semmelrinde/e2-lite-tag-connect-tc2030-adapter/images/schematic.pdf

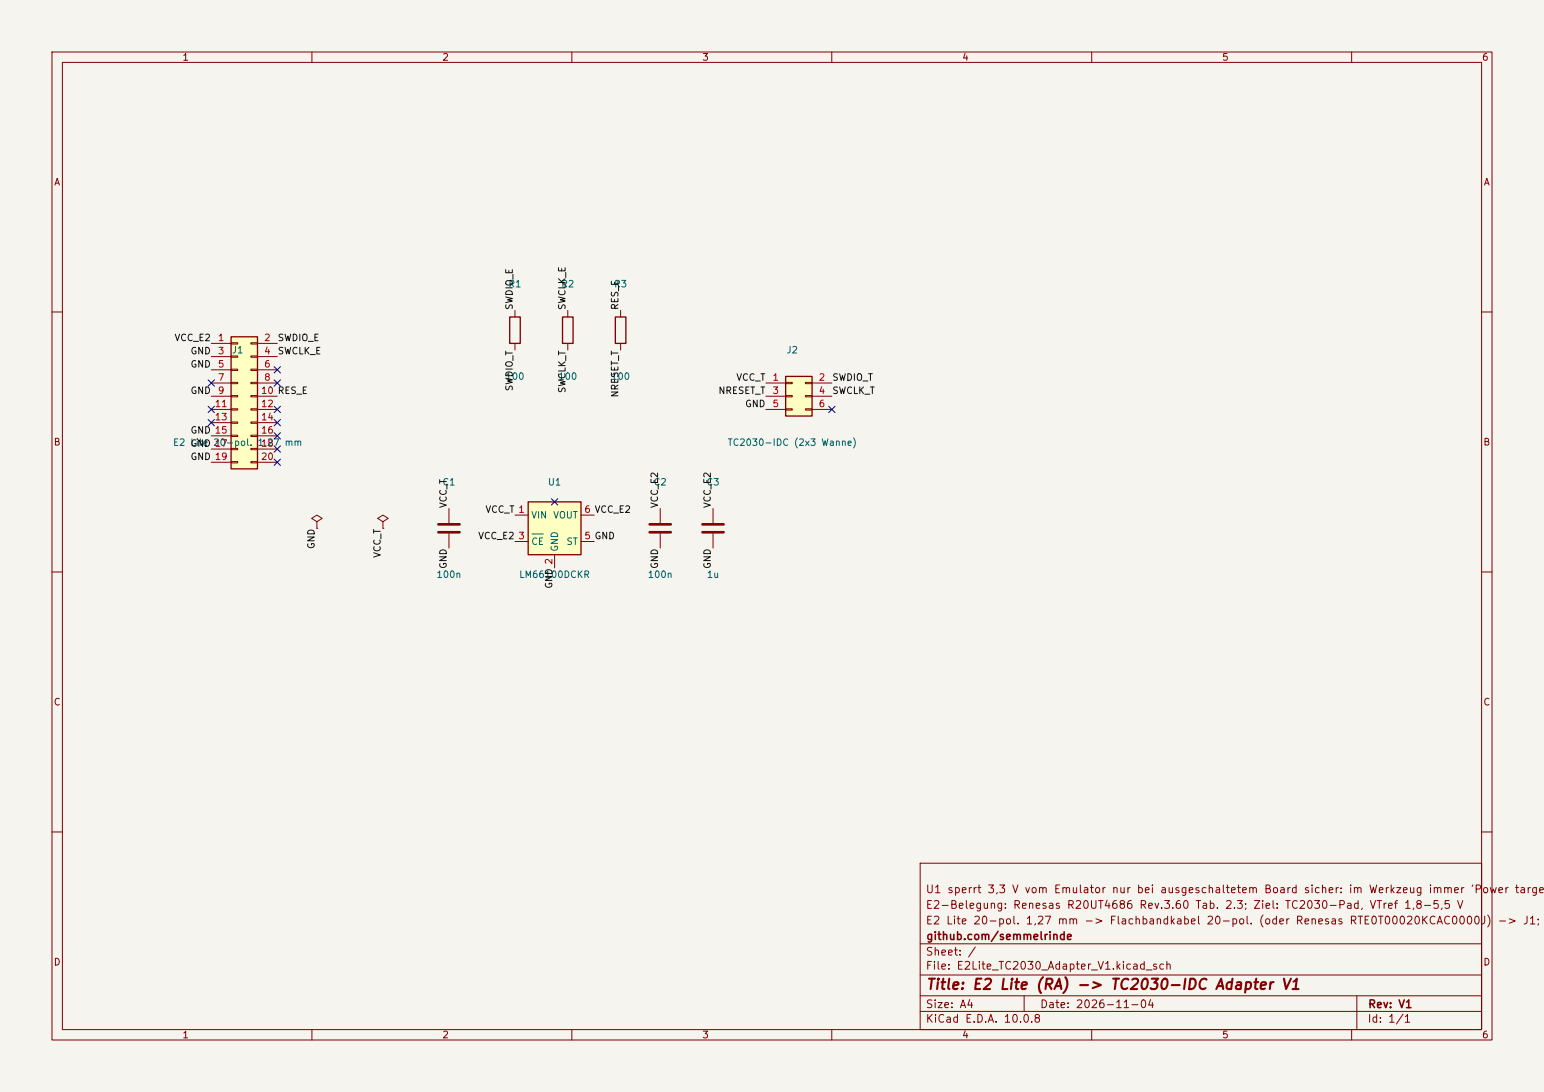
[picture p4: page 1]

U1 sperrt 3,3 V vom Emulator nur bei ausgeschaltetem Board sicher: im Werkzeug immer 'Power target: No'
E2-Belegung: Renesas R20UT4686 Rev.3.60 Tab. 2.3; Ziel: TC2030-Pad, VTref 1,8-5,5 V
E2 Lite 20-pol. 1,27 mm -> Flachbandkabel 20-pol. (oder Renesas RTE0T00020KCAC0000J) -> J1; TC2030-IDC -> J2
github.com/semmelrinde
Sheet: /
File: E2Lite_TC2030_Adapter_V1.kicad_sch
Title: E2 Lite (RA) -> TC2030-IDC Adapter V1

Size: A4 | Rev: V1
KiCad E.D.A. 10.0.8 | Id: 1/1
