semmelrinde/e2-lite-tag-connect-tc2030-adapter/hardware/E2Lite_TC2030_Adapter_V1.kicad_pcb

## KiCad design hardware/E2Lite_TC2030_Adapter_V1.kicad_pcb (2026-11-04)

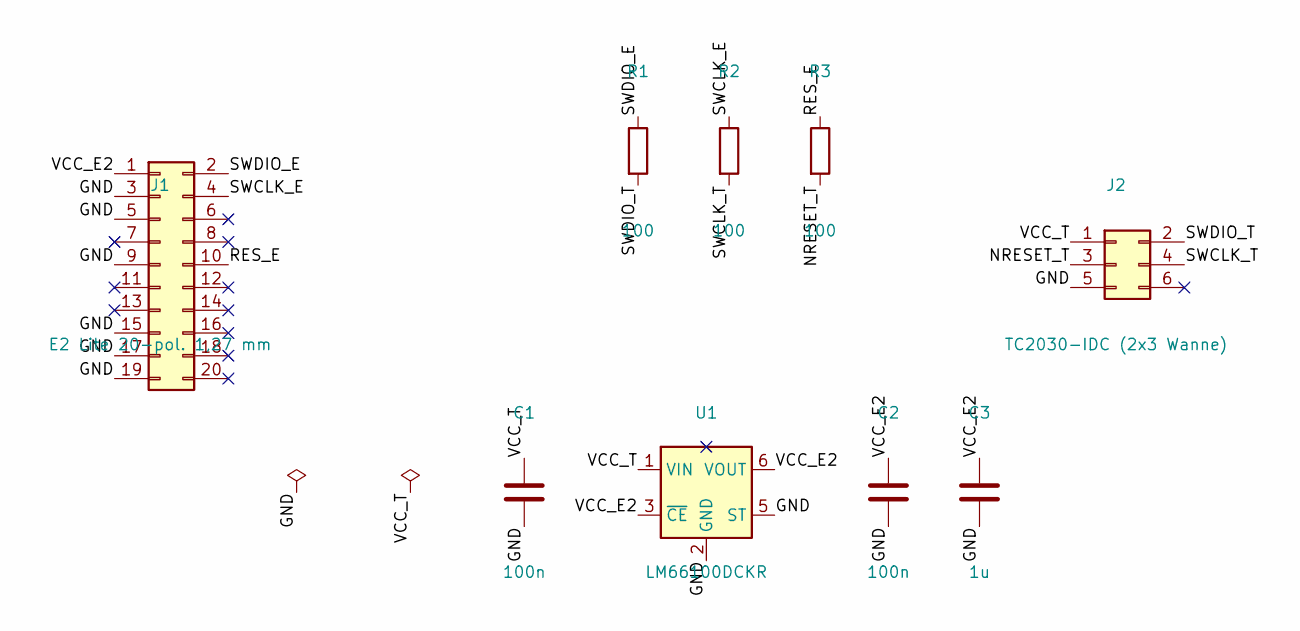
[picture p5: schematic E2Lite_TC2030_Adapter_V1.kicad_sch, E2 Lite (RA) -> TC2030-IDC Adapter V1]

Parts:
C1, C2: 100n; C_0603_1608Metric_Pad1.08x0.95mm_HandSolder; MPN 100 nF 0603
C3: 1u; C_0603_1608Metric_Pad1.08x0.95mm_HandSolder; MPN 1 uF 0603
J1: E2 Lite 20-pol. 1,27 mm; BoxHeader_2x10_P1.27mm_Vertical_DC3; MPN DC3 Wannenstecker 2x10 1,27 mm gerade T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
J2: TC2030-IDC (2x3 Wanne); IDC-Header_2x03_P2.54mm_Vertical; MPN Wannenstecker 2x3 2,54 mm gerade THT
R1, R2, R3: 100; R_0603_1608Metric_Pad0.98x0.95mm_HandSolder; MPN 100 Ohm 0603
U1: LM66100DCKR; SOT-363_SC-70-6_HandSolder; MPN LM66100DCKR

Connections:
/GND: C1.2, C2.2, C3.2, J1.3, J1.5, J1.9, J1.15, J1.17, J1.19, J2.5, U1.2 (GND), U1.5 (ST)
/NRESET_T: J2.3, R3.2
/RES_E: J1.10, R3.1
/SWCLK_E: J1.4, R2.1
/SWCLK_T: J2.4, R2.2
/SWDIO_E: J1.2, R1.1
/SWDIO_T: J2.2, R1.2
/VCC_E2: C2.1, C3.1, J1.1, U1.3 (~CE), U1.6 (VOUT)
/VCC_T: C1.1, J2.1, U1.1 (VIN)

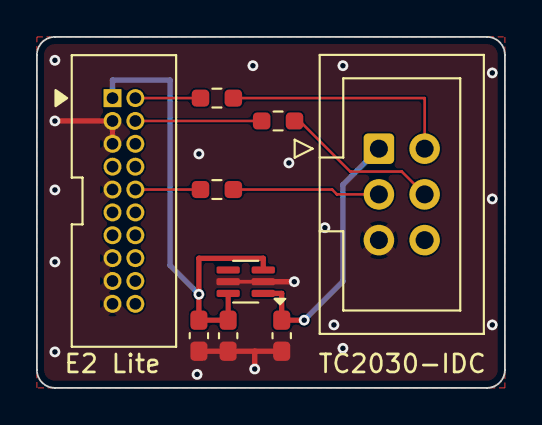
[picture p6: board E2Lite_TC2030_Adapter_V1.kicad_pcb from above]

Board: 2 copper layers, 26.0 x 19.5 mm, 9 parts (0 on the bottom side), 9 nets.
