semmelrinde/e2-lite-tag-connect-tc2030-adapter/(commit log)

2026-11-04 Initial release: KiCad project, Gerbers, BOM and documentation
    [E2Lite_TC2030_Adapter_V1.kicad_pcb, E2Lite_TC2030_Adapter_V1.kicad_sch, bom.csv]
2026-11-04 Sourcing: DigiKey part numbers for J1, J2 and U1
    [bom.csv]
